ZackHirshhorn/minimal-abs-toolhead-v02/output/inserts/render_ducts.png

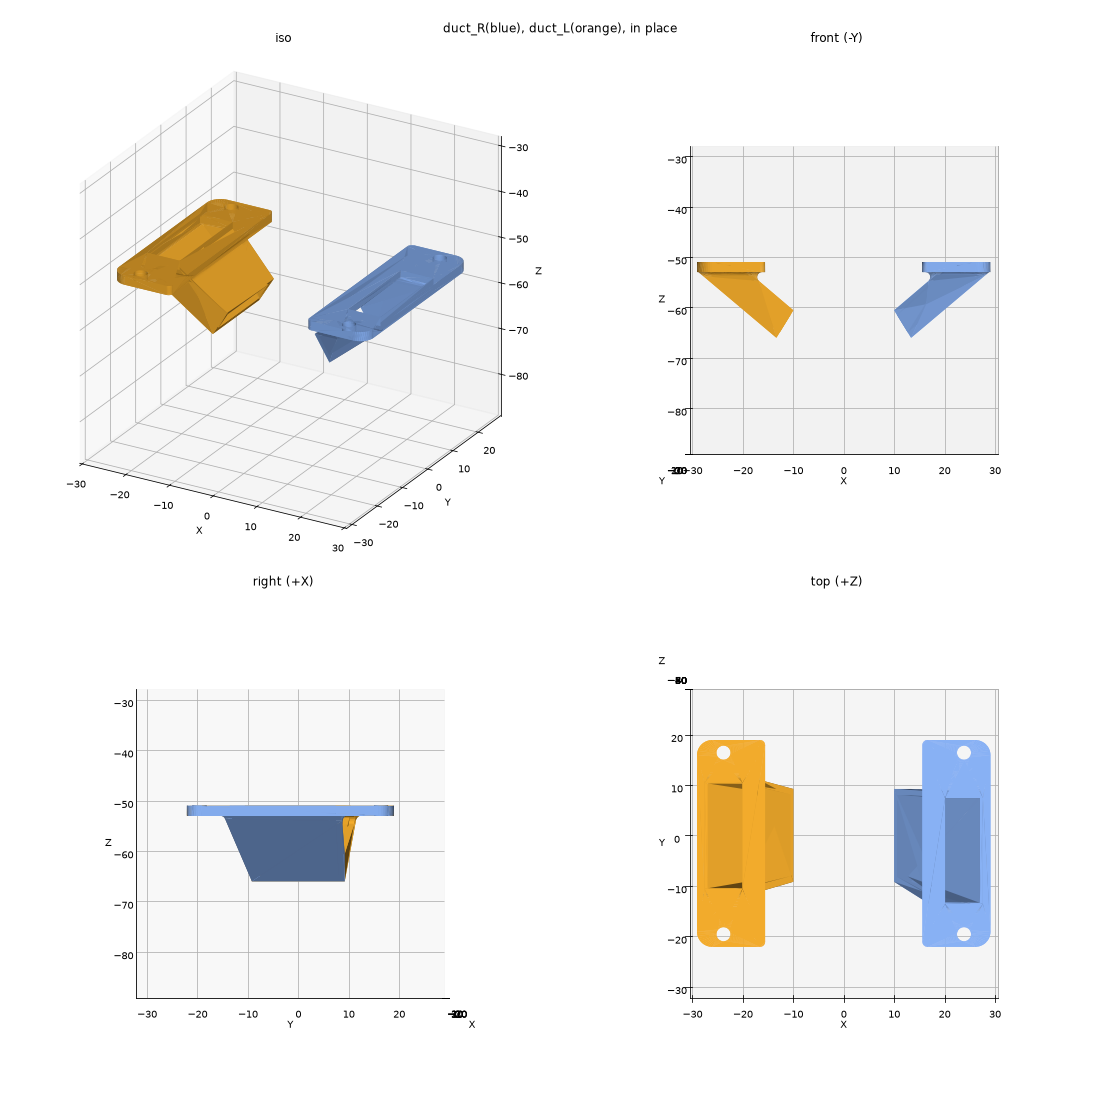
output/inserts/render_ducts.png
