ZackHirshhorn/minimal-abs-toolhead-v02/output/inserts/render_part.png

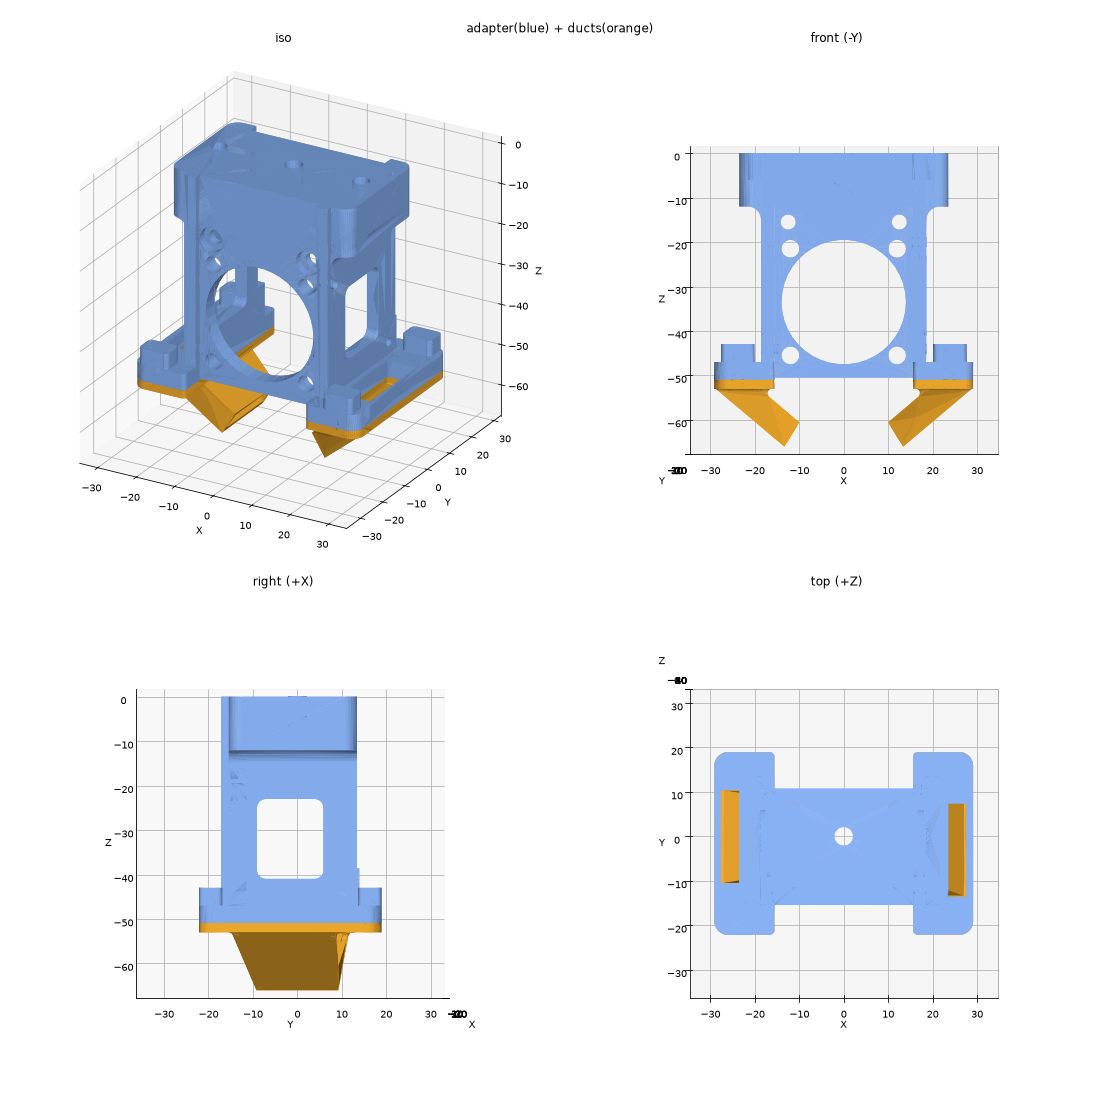
output/inserts/render_part.png
