ZackHirshhorn/minimal-abs-toolhead-v02/output/carriage_mount.step

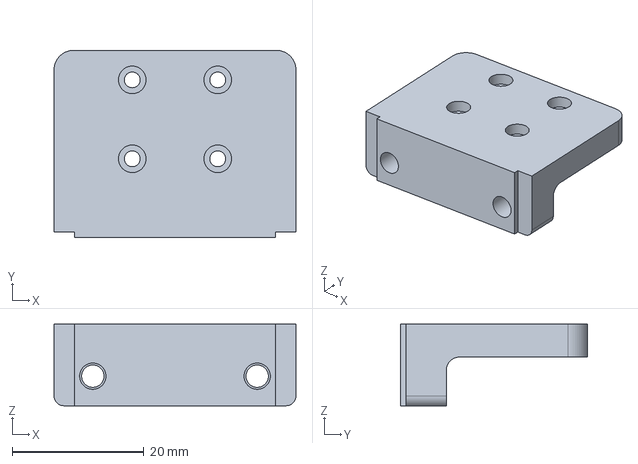
[picture p4: CAD file, 2026-10-27]
output/carriage_mount.step
36.8 x 28.5 x 12.4 mm
