ZackHirshhorn/minimal-abs-toolhead-v02/output/inserts/duct_L.step

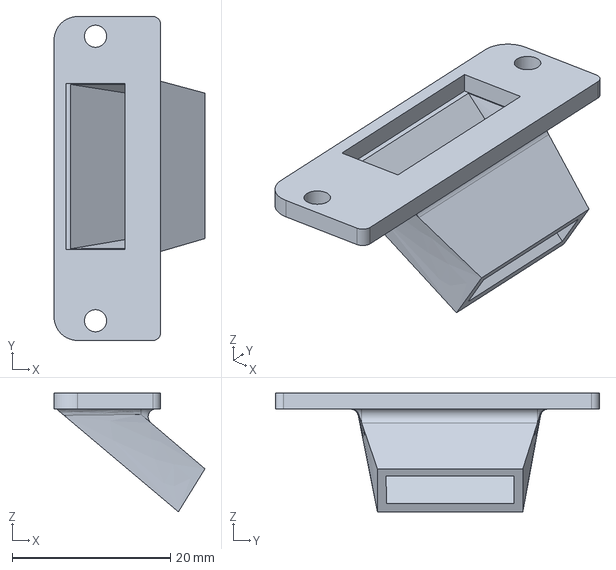
[picture p5: CAD file, 2026-11-04]
output/inserts/duct_L.step
19.1 x 41.0 x 15.0 mm
