ZackHirshhorn/minimal-abs-toolhead-v02/output/nuts/toolboard_mount.step

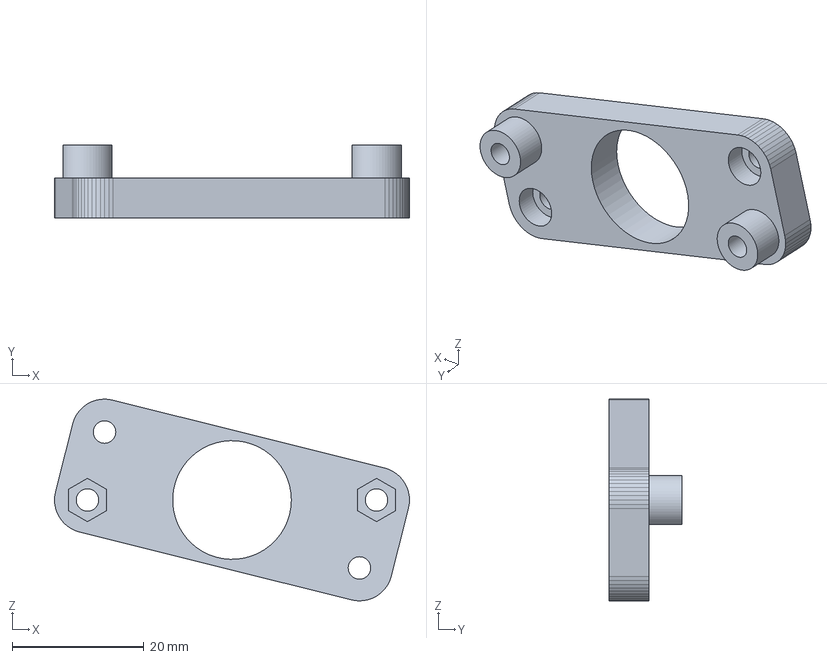
[picture p6: CAD file, 2026-11-04]
output/nuts/toolboard_mount.step
53.9 x 11.0 x 30.6 mm
