ZackHirshhorn/minimal-abs-toolhead-v02/output/nuts/duct_R.step

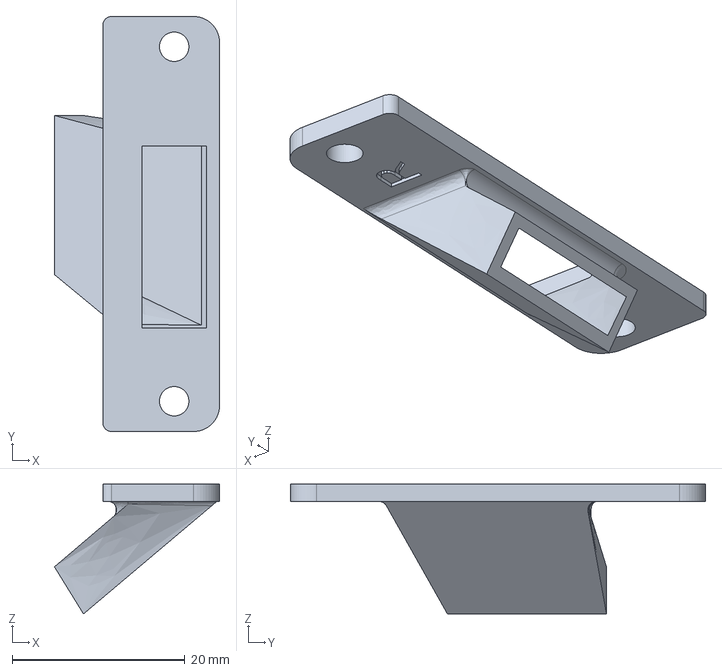
[picture p7: CAD file, 2026-11-04]
output/nuts/duct_R.step
19.1 x 48.0 x 15.0 mm
