ZackHirshhorn/minimal-abs-toolhead-v02/output/inserts/toolhead_adapter.step

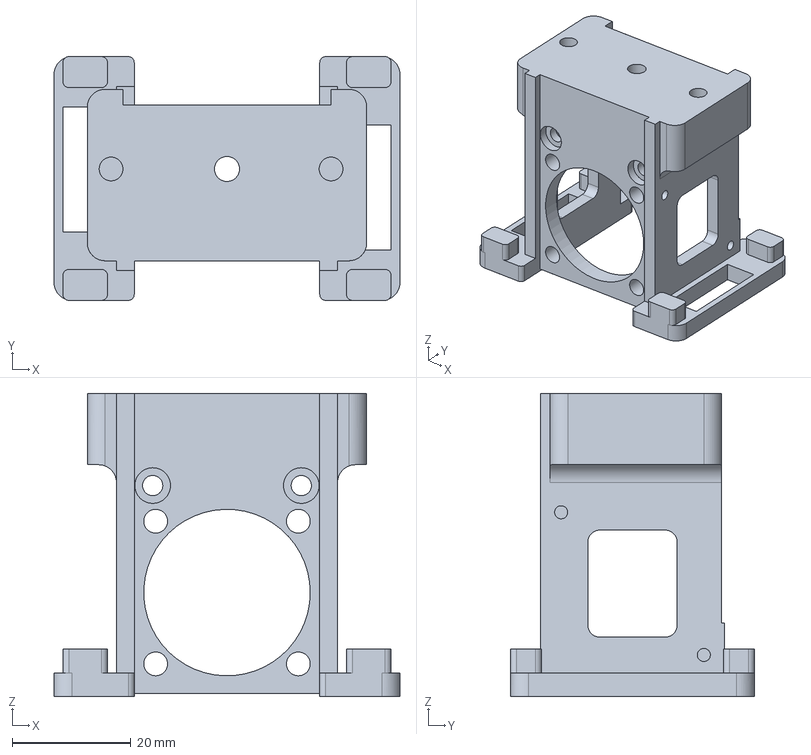
[picture p8: CAD file, 2026-11-04]
output/inserts/toolhead_adapter.step
58.2 x 41.0 x 51.0 mm
