ZackHirshhorn/minimal-abs-toolhead-v02/output/nuts/fit_test.step

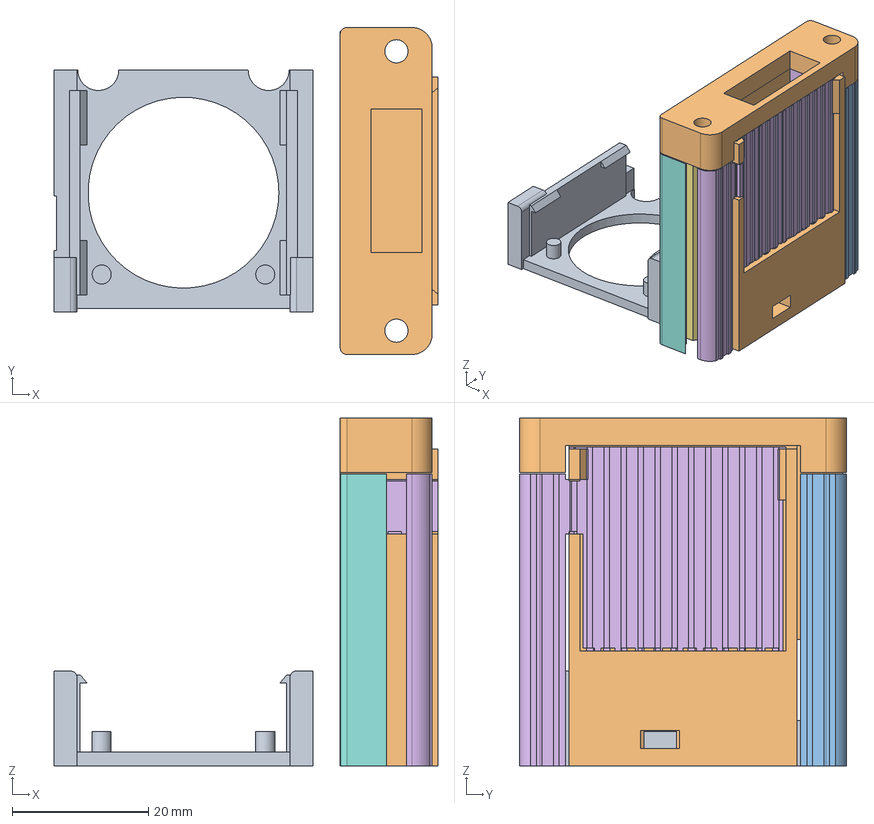
[picture p9: CAD file, 2026-11-04]
output/nuts/fit_test.step
56.4 x 48.0 x 51.0 mm
