ZackHirshhorn/minimal-abs-toolhead-v02/output/nuts/toolhead_adapter.step

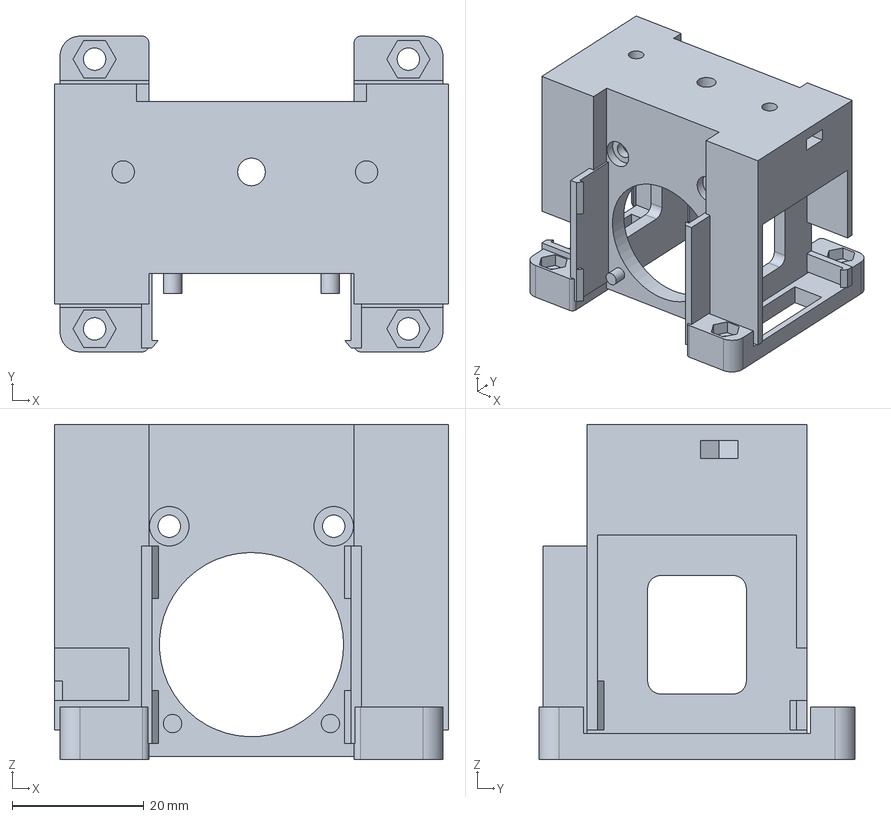
[picture p11: CAD file, 2026-11-04]
output/nuts/toolhead_adapter.step
59.9 x 48.0 x 51.0 mm
