ZackHirshhorn/minimal-abs-toolhead-v02/(list of files, cad)

Other CAD files:
output/inserts/duct_R.step
output/nuts/duct_L.step
output/inserts/duct_L.stl
output/inserts/duct_R.stl
output/inserts/toolboard_mount.stl
output/inserts/toolhead_adapter.stl
output/nuts/duct_L.stl
output/nuts/duct_R.stl
output/nuts/fit_test.stl
output/nuts/toolboard_mount.stl
output/nuts/toolhead_adapter.stl
