ZackHirshhorn/minimal-abs-toolhead-v02/output/inserts/render_print.png

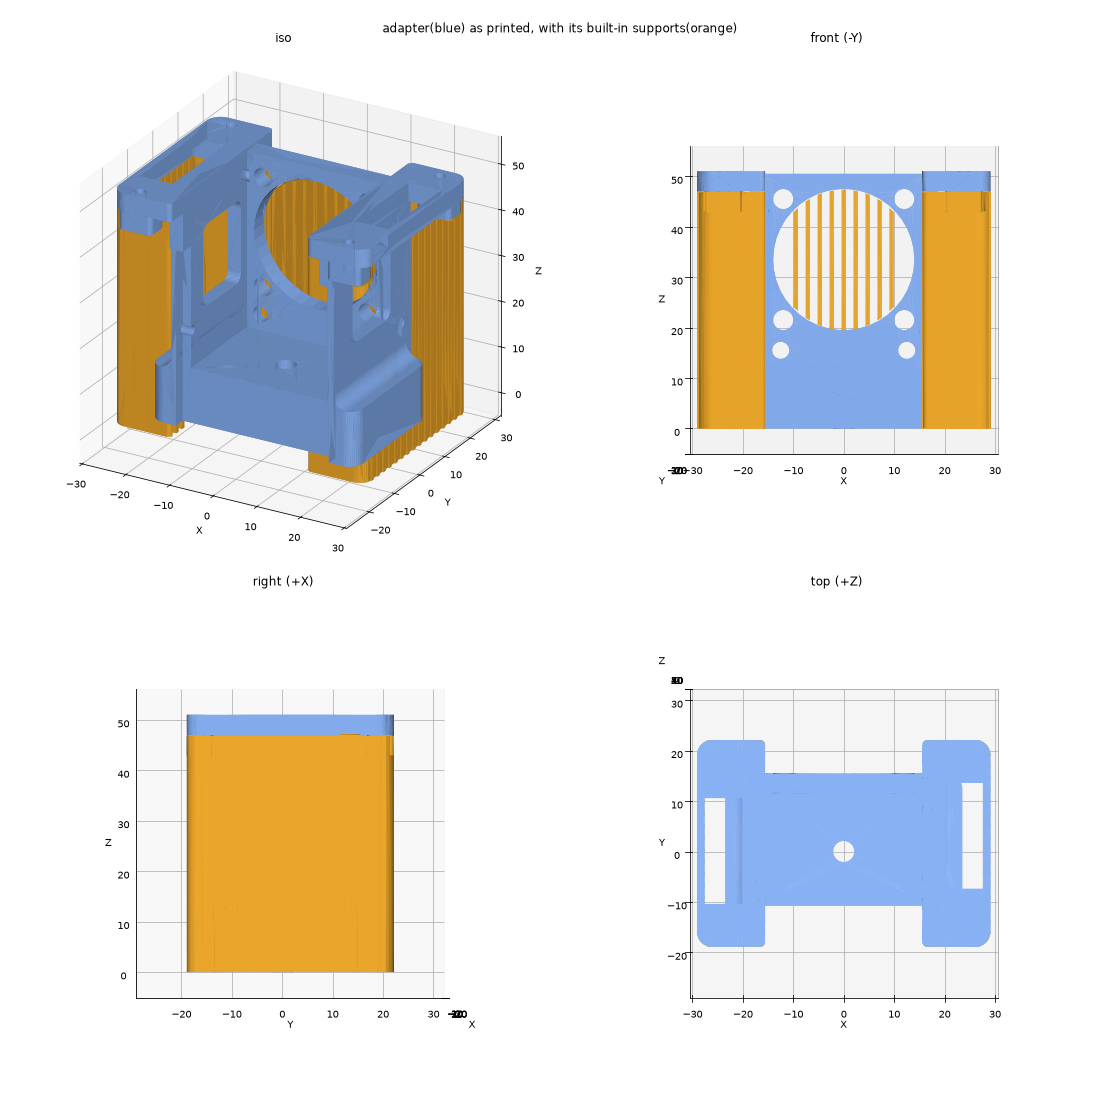
output/inserts/render_print.png
