ZackHirshhorn/minimal-abs-toolhead-v02/output/nuts/render_fit_test.png

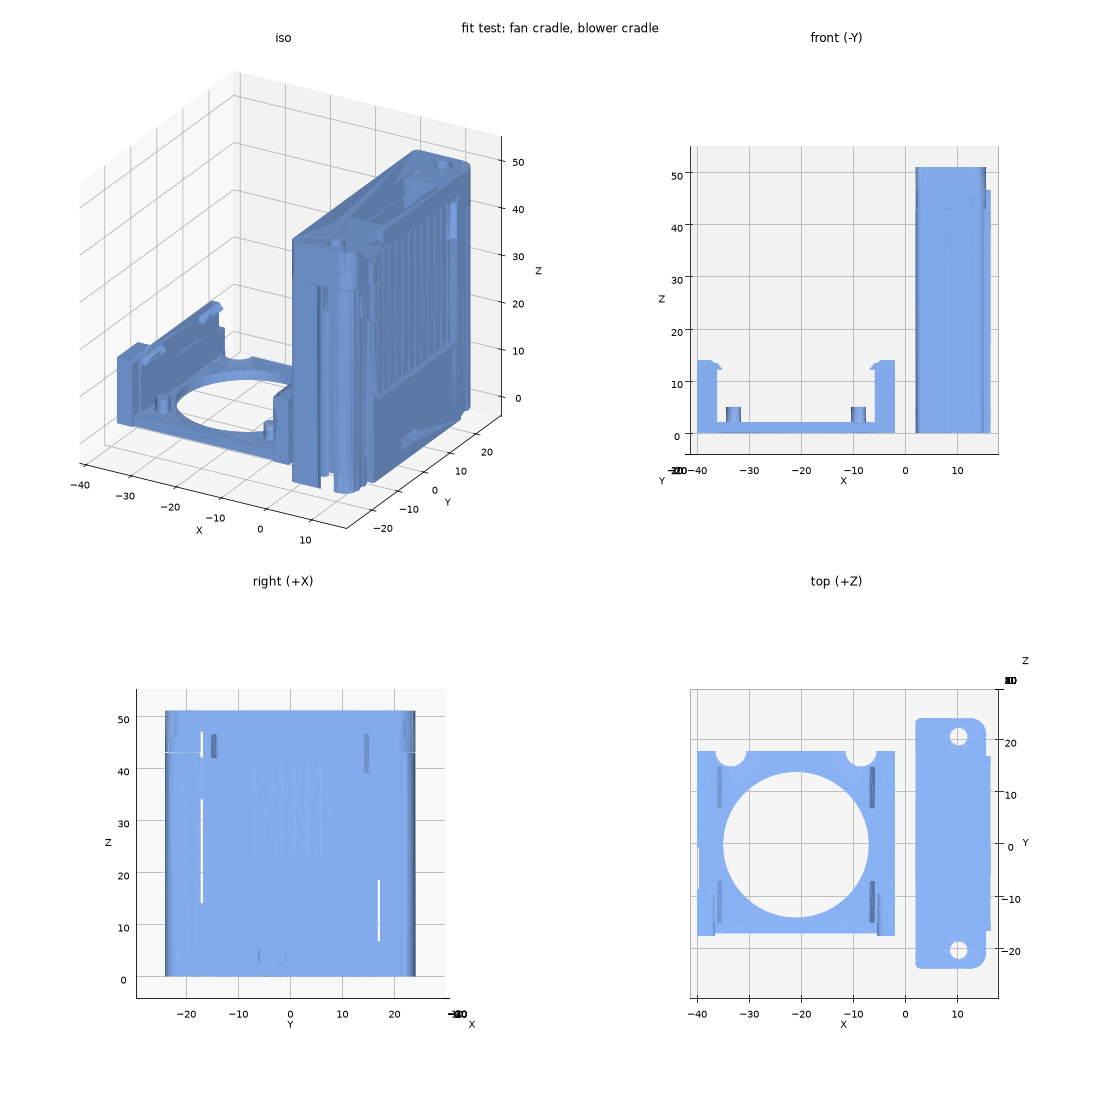
output/nuts/render_fit_test.png
