ZackHirshhorn/minimal-abs-toolhead-v02/(commit log)

2026-10-27 Initial commit: WW BMG to TZ-V6 2.0 toolhead adapter
    Parametric build123d adapter script with STEP inspection/render helpers,
    generated adapter STEP/STL and renders, README and GPL-3.0 license.
    Third-party models (BMG, hotend mount, fan, blower) are not included.
    [toolhead_adapter.step, toolhead_adapter.stl]
2026-10-27 Separate replaceable ducts, closed frame, real hotend placement
    - Place the TZ-V6 2.0 hotend from "assy hotend kit.stp", used without its
    top part as on the Mini Stealthburner: nozzle tip is now 58.9 mm below
    the mount top (computed, no longer estimated).
    - Split the part-cooling ducts into a separate part (print 2) screwed to a
    shelf under each blower, so the hottest parts can be swapped or printed
    in a more heat-resistant material. Duct exit is solved to keep a 5 mm
    gap to the heater block.
    - Extend the front plate and back tab to the blower arms, closing the
    frame: back insert wall 0.9 -> 4.1 mm, counterbore no longer breaks out,
    fan plate walls 1.0/1.4 -> 3.0/4.6 mm.
    - Rais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
    [duct.step, duct.stl, toolhead_adapter.step, toolhead_adapter.stl]
2026-10-27 Add fillets to adapter and ducts
    Round the top plate corners, shelf and duct flange outlines, screw lugs
    and arm windows; add a concave fillet under the top plate overhang at
    each arm and at the duct's flange-to-tube junction. No fillets inside
    the mount bay, in the blower seats, or on the top (bed) face.
    [duct.step, duct.stl, toolhead_adapter.step, toolhead_adapter.stl]
2026-10-27 Add BOM and step-by-step assembly instructions
2026-10-27 Add MGN7H carriage mount for Voron 0.2 X axis
    L-bracket that sits on top of the MGN7H carriage under the BMG motor and
    bolts to the adapter's back face through the hotend-mount screws (M3x35,
    inserts move from the back tab into the flange).
    [carriage_mount.step, carriage_mount.stl]
2026-10-28 Add captive-nut version, fix BMG hole spacing, use TZ-V6 2.0 spec
    Captive-nut version (--nuts, output/nuts/): no heat-set inserts and no
    self-tapping screws. M3 nuts sit in slots and pockets at the BMG, the
    back tab, the carriage flange and the duct lugs. The 3010 fan and both
    blowers snap into cradles with no screws. Includes a fit test print and
    ASSEMBLY_NUTS.md.
    Fixes affecting both versions:
    - BMG screw holes at +-17.5 mm (was 18.5), per the official model
    - Hotend stand-in built from the TZ-V6 2.0 drawing: tip 45.6 mm below
    the heatsink top, 10 x 8.2 x 17 heater. Ducts move in to keep 5 mm
    Outputs split into output/inserts/ and output/nuts/, ducts renamed
    2x_duct, and STLs exported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
    [2x_duct.step, 2x_duct.stl, carriage_mount.step, carriage_mount.stl, duct.step, duct.stl, fit_test.step, fit_test.stl]
2026-10-28 Keep third-party models in a single ignored third_party/ folder
    The scripts load the vendor models from third_party/ instead of the repo
    root, so the folder can be copied as a whole to a new clone. It also
    holds the reference material (Voron hotend mounts, TZ-V6 drawing,
    fan and blower photos).
2026-10-28 Merge the carriage mount into the adapter, flatten the top face
    The carriage mount was a separate L-bracket held to the adapter's back
    face only by the two hotend-mount screws, so X moves twisted that joint
    with only friction resisting. It is now fused onto the adapter
    (carriage_mount.py builds it, toolhead_adapter.build_part() adds it);
    there is no separate carriage_mount part any more.
    - Hotend-mount screws: M3x35 in both versions, through the back tab into
    M3 nuts dropped into slots in the flange's top face (the back tab's
    inserts or nut pockets would be buried by the merge). Their holes are
    blind now, closed 0.9 mm before the flange's back face.
    - Back tab 5 mm in both versions (w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
    [2x_duct.step, carriage_mount.step, carriage_mount.stl, fit_test.step, fit_test.stl, toolhead_adapter.step, toolhead_adapter.stl]
2026-10-29 Add built-in supports to the adapter STL
    Thin support walls under the overhangs that can't bridge: the shelf over
    each blower bay, the duct lug tops, the fan opening, and (captive-nut
    version) the fan cradle walls and blower wire notches. They stop one
    0.2 mm layer short of the face they hold up and touch the part only at
    short tabs. Keepouts around every nut pocket and slot keep supports out.
    The STEP files and the assembly stay without supports.
    [2x_duct.step, fit_test.step, fit_test.stl, toolhead_adapter.step, toolhead_adapter.stl]
2026-10-29 Add an EBB36 CAN toolboard mount on the BMG motor standoffs
    The board mounts on two M3 F-F standoffs threaded onto longer motor screws.
    The motor screws sit on a 28 deg diagonal, so the mount turns the board level
    and centres it on the motor, keeping it clear of the carriage mount.
    [toolboard_mount.step, toolboard_mount.stl]
2026-11-04 Hang the adapter on the Voron X carriage at the Mini SB nozzle position
    The adapter had an MGN7H carriage mount built in, with nowhere to clamp the
    belts. It now hangs on the separate Voron 0.2 X carriage, like the Mini
    Stealthburner, so it can replace one without changing the printer.
    - Removed the carriage mount and the back tab. The mount module sits straight
    on the X carriage face, 10.85 mm behind the filament axis, as on the Mini SB.
    Hotend-mount screws are M3x30, into the nuts in the X carriage.
    - carriage_mount.py now places the X carriage STL (nuts or inserts version),
    MGN7H, rail, extrusion and belts, and checks them against the adapter.
    - Notched the top plate over the X car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
    [2x_duct.step, 2x_duct.stl, duct_L.step, duct_L.stl, duct_R.step, duct_R.stl, fit_test.step, fit_test.stl]
